atsulliv/PCB-AudioAmplifier/pcb/tutorial_blinky_pcb.jpg

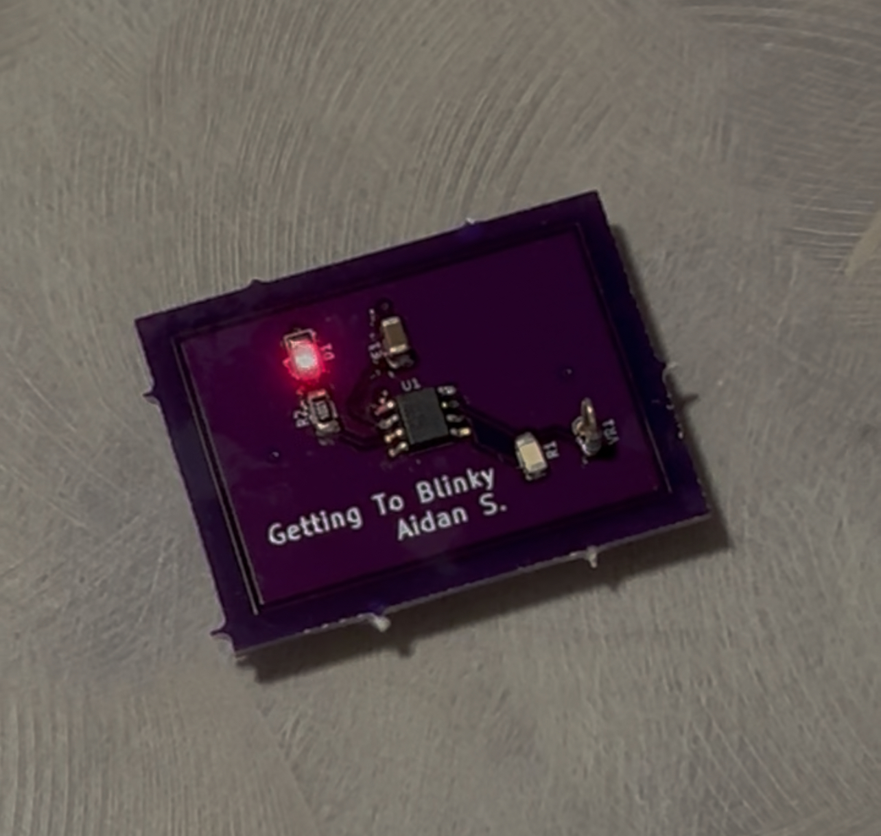
pcb/tutorial_blinky_pcb.jpg
