atsulliv/PCB-AudioAmplifier/photos/amplifier2.jpg

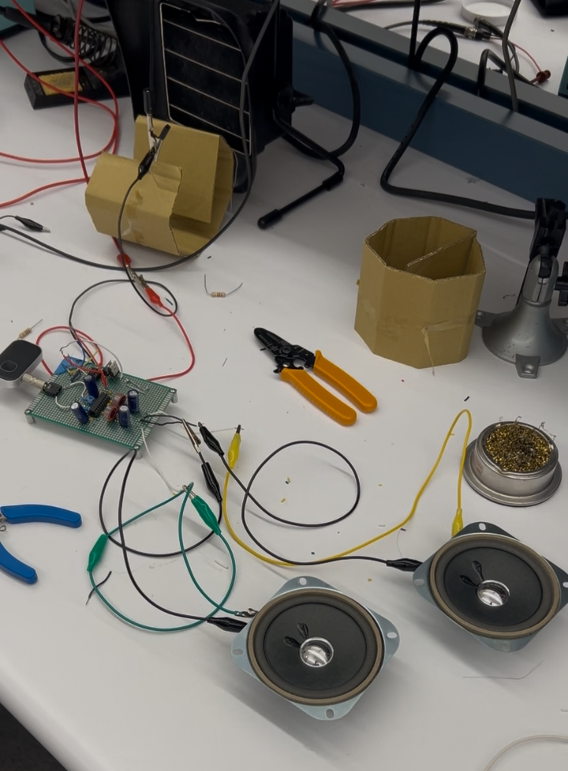
photos/amplifier2.jpg
