atsulliv/PCB-AudioAmplifier/pcb/ee101pcb_side_a.jpg

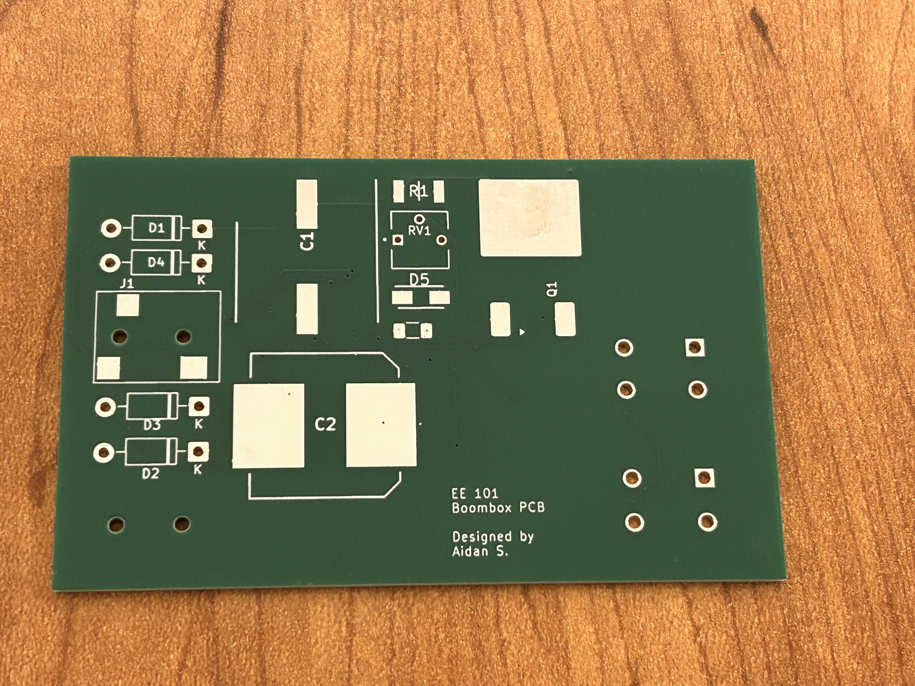
pcb/ee101pcb_side_a.jpg
