atsulliv/PCB-AudioAmplifier/pcb/ee101pcb_side_b.jpg

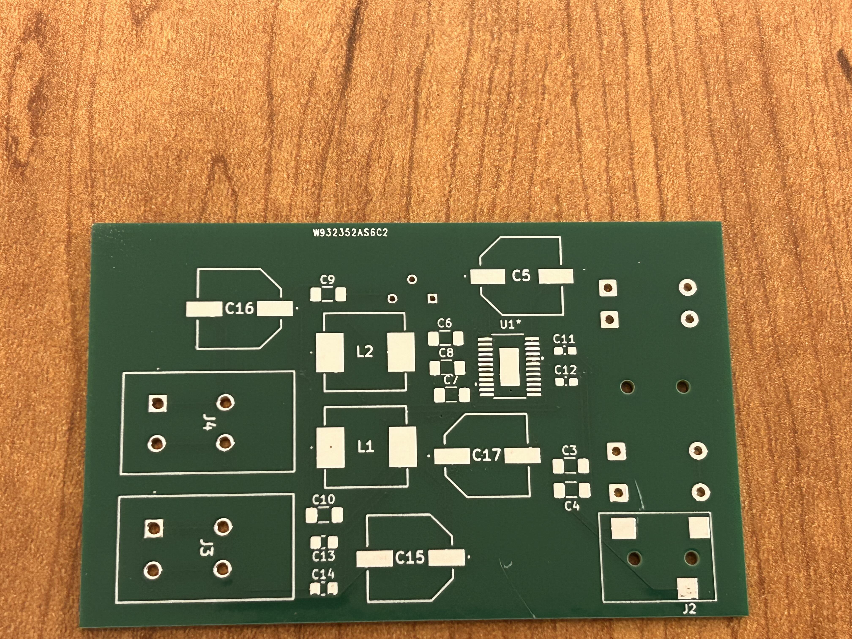
pcb/ee101pcb_side_b.jpg
