atsulliv/PCB-AudioAmplifier/photos/amplifier1.jpg

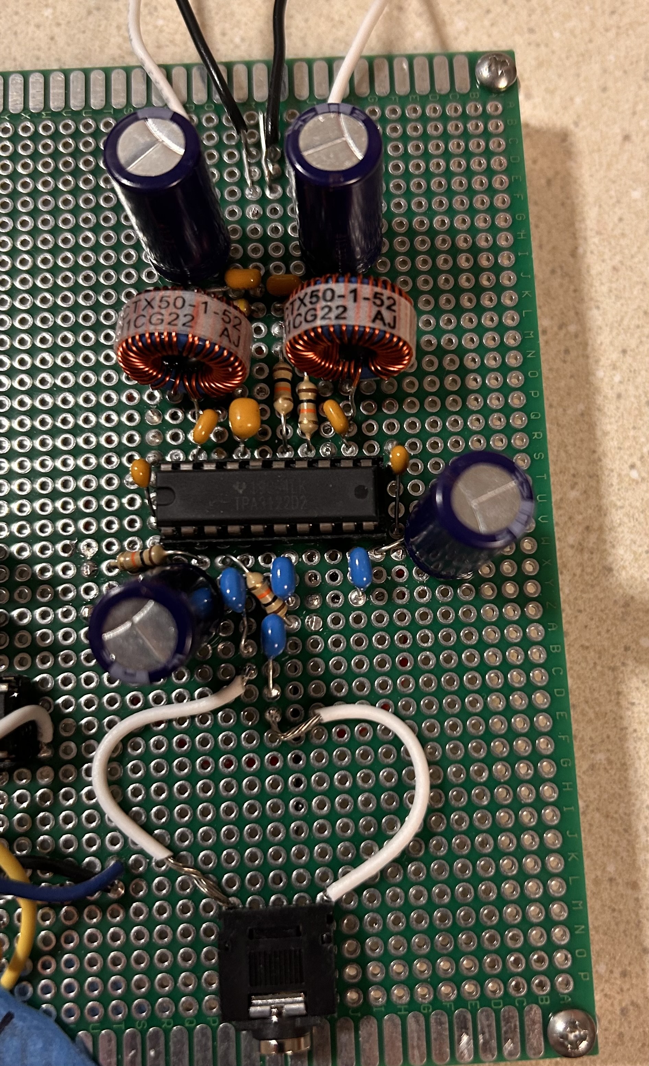
photos/amplifier1.jpg
