atsulliv/PCB-AudioAmplifier/kicad/EE101_Board/EE101_Board.step

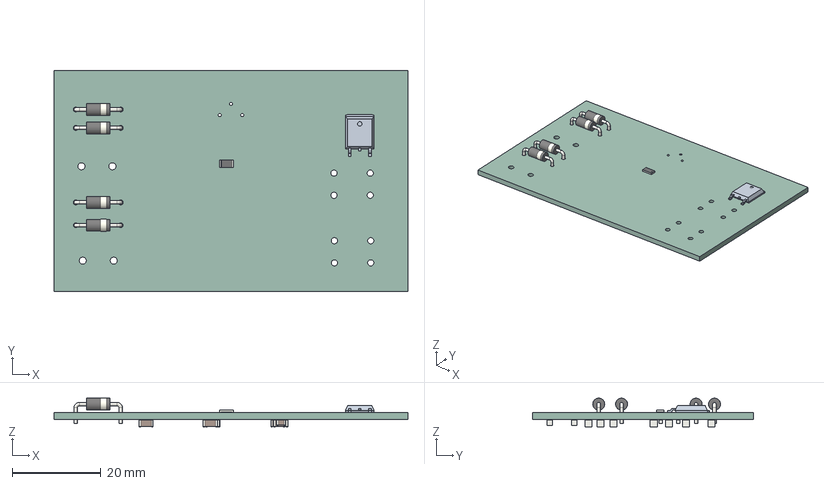
[picture p6: CAD file, 2026-01-06]
kicad/EE101_Board/EE101_Board.step
80.0 x 50.0 x 6.49 mm
EE101_Board 1.1.1
D_DO-41_SOD81_P10.16mm_Horizontal x 4
R_1206_3216Metric
C_0603_1608Metric x 2
C_1206_3216Metric x 7
C_0805_2012Metric x 2
EE101_Board_PCB
