atsulliv/PCB-AudioAmplifier/kicad/EE101_Board/EE101_Board.kicad_pcb

## KiCad design kicad/EE101_Board/EE101_Board.kicad_pcb (2026-01-06)

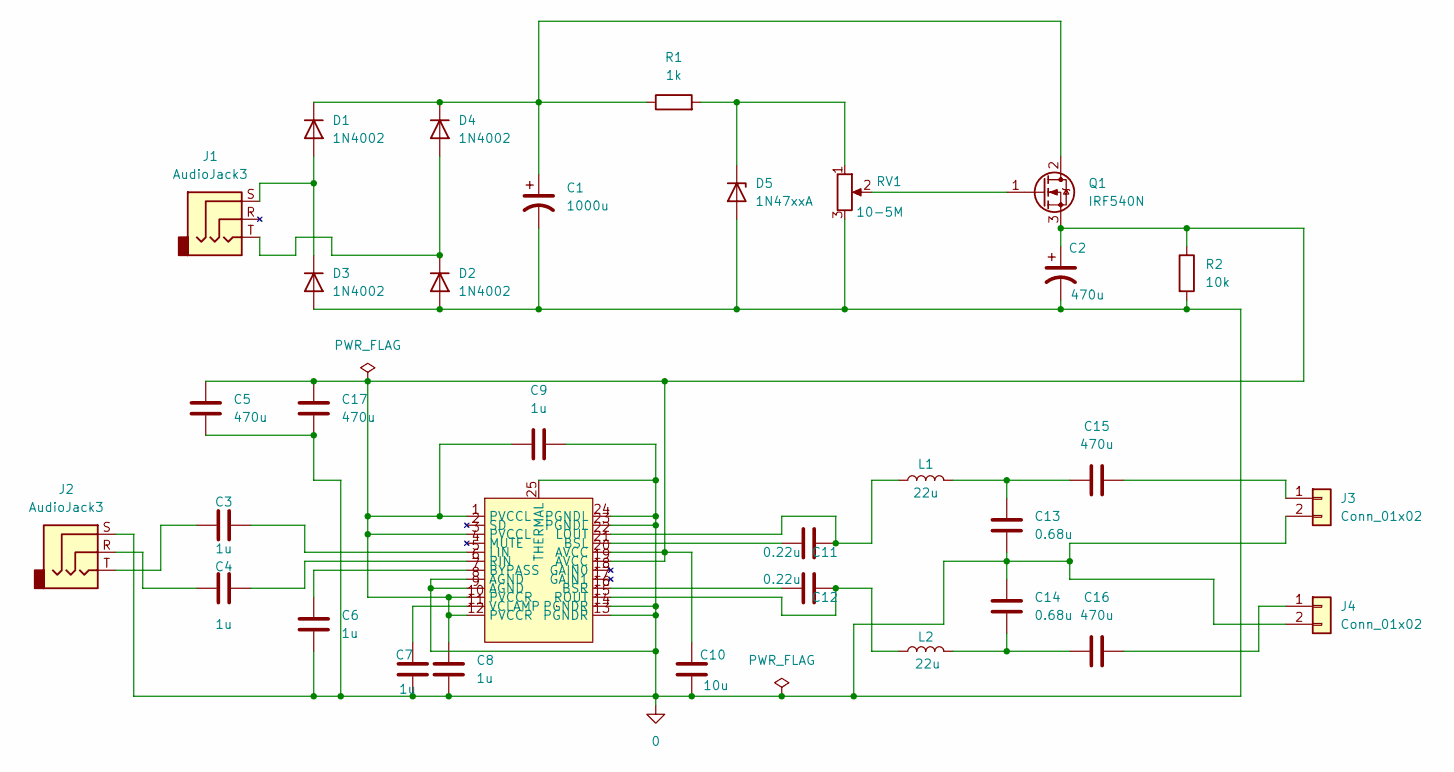
[picture p7: schematic EE101_Board.kicad_sch]

Parts:
C1: 1000u; CAPAE1600X1700N
C2: 470u; C-MAL216099003E3
C3, C4, C6, C7, C8, C9: 1u; C_1206_3216Metric_Pad1.33x1.80mm_HandSolder
C5, C15, C16, C17: 470u; Panasonic 25SVPG470M
C10: 10u; C_1206_3216Metric_Pad1.33x1.80mm_HandSolder
C11, C12: 0.22u; C_0603_1608Metric_Pad1.08x0.95mm_HandSolder
C13, C14: 0.68u; C_0805_2012Metric_Pad1.18x1.45mm_HandSolder
D1, D2, D3, D4: 1N4002; D_DO-41_SOD81_P10.16mm_Horizontal
D5: 1N47xxA; DIOM5226X240N
J1, J2: AudioJack3; CUI_SJ-3523-SMT-TR
J3, J4: Conn_01x02; 2249290002
L1, L2: 22u; SRP1038WA220M
Q1: IRF540N; D2PAK-IRF940N
R1: 1k; RESC5025X70N
R2: 10k; R_1206_3216Metric_Pad1.30x1.75mm_HandSolder
RV1: 10-5M; TRIM_3362P-1-205LF
U1: TPA-3123D2-TSSOP - 1.2 mm max height

Connections:
0: C1.2, C2.2, C5.2, C6.2, C7.2, C8.2, C9.2, C10.2, C13.2, C14.1, C17.2, D2.2 (A), D3.2 (A), D5.2 (A), J2.S, J3.2, J4.2, R2.2, RV1.3, U1.8 (AGND), U1.9 (AGND), U1.13 (PGNDR), U1.14 (PGNDR), U1.23 (PGNDL), U1.24 (PGNDL), U1.25 (THERMAL)
unnamed: C3.1, J2.T
unnamed: C4.1, J2.R
unnamed: C13.1, C15.1, L1.2
unnamed: C14.2, C16.1, L2.2
unnamed: D1.2 (A), D3.1 (K), J1.S
unnamed: C1.1, D1.1 (K), D4.1 (K), Q1.2 (D), R1.1
unnamed: D2.1 (K), D4.2 (A), J1.T
unnamed: D5.1 (K), R1.2, RV1.1
unnamed: C15.2, J3.1
unnamed: C16.2, J4.1
unnamed: Q1.1 (G), RV1.2
unnamed: C2.1, C5.1, C8.1, C9.1, C10.1, C17.1, Q1.3 (S), R2.1, U1.1 (PVCCL), U1.3 (PVCCL), U1.10 (PVCCR), U1.12 (PVCCR), U1.19 (AVCC), U1.20 (AVCC)
unnamed: C11.1, U1.21 (BSL)
unnamed: C12.1, U1.16 (BSR)
unnamed: C6.1, U1.7 (BYPASS)
unnamed: C3.2, U1.5 (LIN)
unnamed: C11.2, L1.1, U1.22 (LOUT)
unnamed: C4.2, U1.6 (RIN)
unnamed: C12.2, L2.1, U1.15 (ROUT)
unnamed: C7.1, U1.11 (VCLAMP)

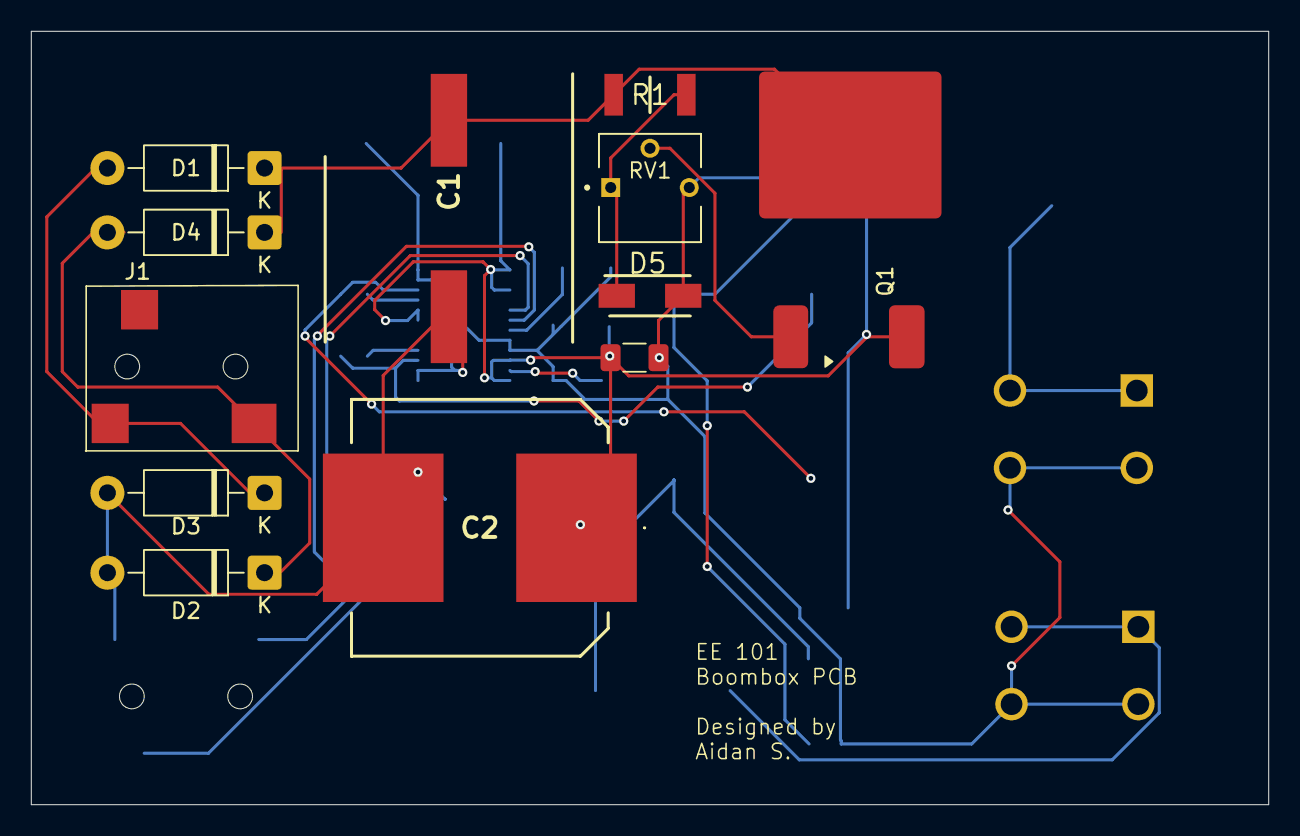
[picture p8: board EE101_Board.kicad_pcb from above]

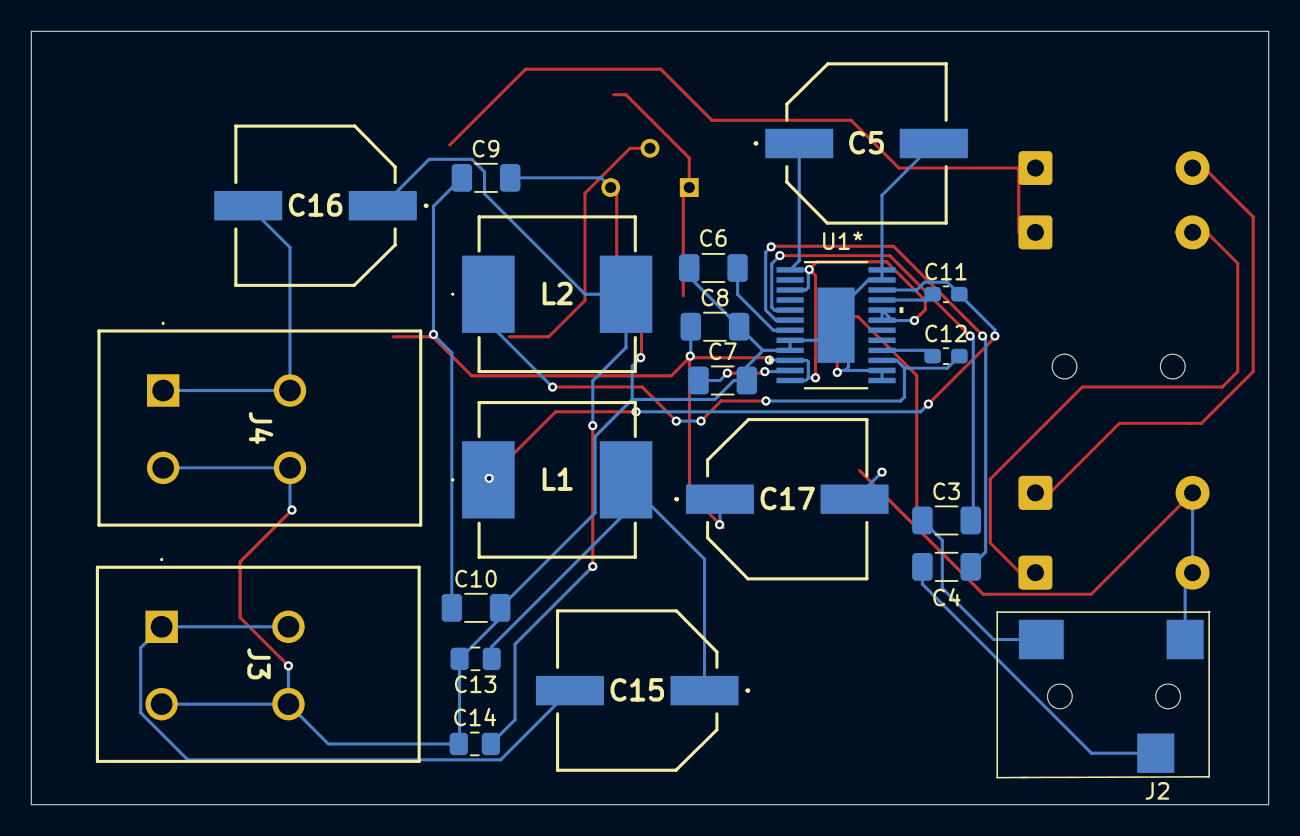
[picture p9: board EE101_Board.kicad_pcb from below]

Board: 2 copper layers, 80.0 x 50.0 mm, 33 parts (21 on the bottom side), 21 nets.
